FAB619/619-J_Stepper/files/Kicad Files/Stepper Servo.kicad_pcb

## KiCad design files/Kicad Files/Stepper Servo.kicad_pcb (2021-04-22)

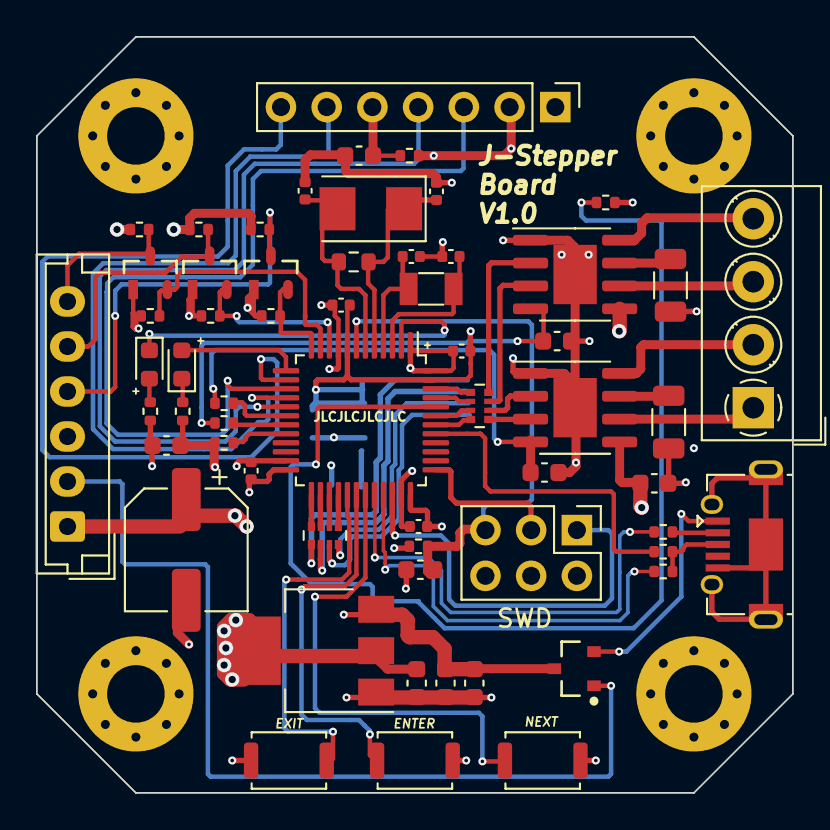
[picture p15: board Stepper Servo.kicad_pcb from above]

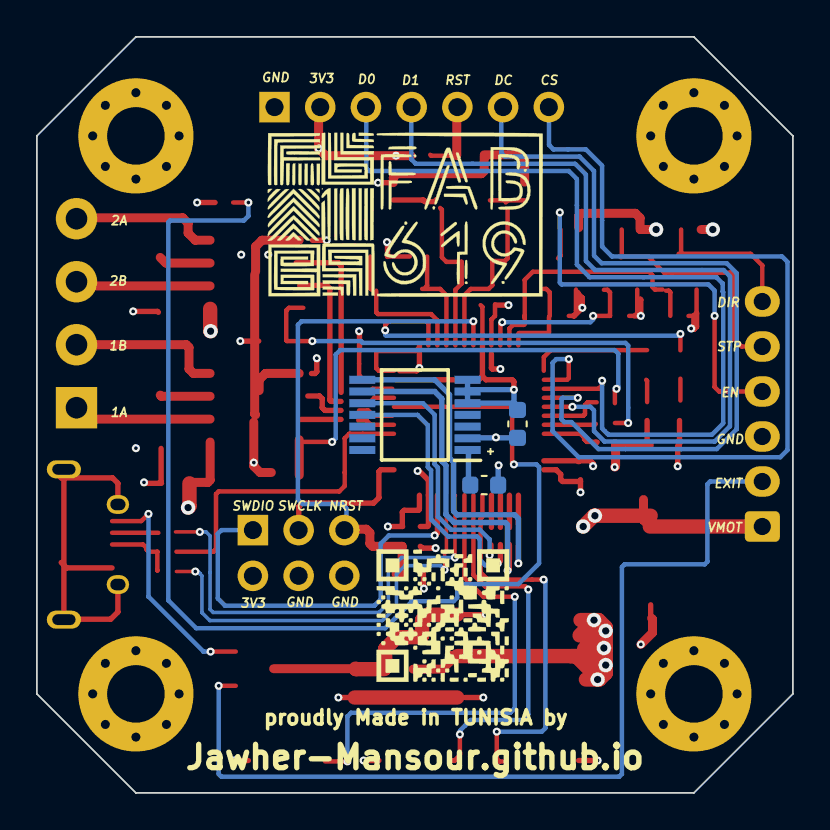
[picture p16: board Stepper Servo.kicad_pcb from below]

Board: 4 copper layers, 42.0 x 42.0 mm, 67 parts (3 on the bottom side), 65 nets.

Parts:
C1, C2, C3, C7, C14, C15, C16, C17, C18, C19, C20: 100nF; C_0603_1608Metric
C4, C5: 10pF; C_0402_1005Metric
C6: 100uF; CP_Elec_6.3x5.3
C8, C9: 22pF; C_0402_1005Metric
C10, C11, C12, C13: 100nF; C_0402_1005Metric
D1: LED; LED_0603_1608Metric
D2: LED_Small; LED_0603_1608Metric
D3: BAT64-05; Infineon-BAT64-05-Level_C
H1, H2, H3, H4: MountingHole_Pad; MountingHole_3.2mm_M3_Pad_Via
IC1: A1333LLETR-5-T; SOP65P640X125-14N
J1: USB_B_Micro; USB_Micro-AB_Molex_47590-0001
J2: SWD; PinHeader_2x03_P2.54mm_Vertical
J3: Motor; TerminalBlock_MetzConnect_Type059_RT06304HBWC_1x04_P3.50mm_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
J4: Screen; PinHeader_1x07_P2.54mm_Vertical
J5: Inputs; JST_EH_B6B-EH-A_1x06_P2.50mm_Vertical
Q1, Q2, Q3: FDN337N; ON_Semi-527AG-01-12_2008-O-IPC_C
R1, R3, R10, R12: 1K; R_0402_1005Metric
R2, R11: 0.1; R_1206_3216Metric
R4, R5, R8, R14, R15, R16, R17, R18, R19, R20: 10K; R_0402_1005Metric
R6, R9: 22; R_0402_1005Metric
R7: 1K5; R_0402_1005Metric
R13: 1M; R_0603_1608Metric
RN1: 10; R_Array_Convex_4x0402
RN2: 100; R_Array_Convex_4x0402
SW1, SW2, SW3: SW_DIP_x01; SW_Push_SPST_NO_Alps_SKRK
U1, U3: A4950E; SOIC-8-1EP_3.9x4.9mm_P1.27mm_EP2.41x3.3mm
U2: STM32F103C8T6; LQFP-48_7x7mm_P0.5mm
U4: AMS1117-3.3; SOT-223-3_TabPin2
Y1: 32K768; Crystal_SMD_3215-2Pin_3.2x1.5mm
Y2: 8MHz; Crystal_SMD_5032-2Pin_5.0x3.2mm

Connections:
1A: J3.1, U3.6
1B: J3.2, U3.8
2A: J3.4, U1.8
2B: J3.3, U1.6
+3V3: C10.2, C11.2, C12.2, C13.2, C19.2, C20.2, J2.2, J4.2, Q1.1, Q2.1, Q3.1, R8.1, R10.2, R14.1, R15.1, R17.1, R19.1, U2.1, U2.9, U2.24, U2.36, U2.48, U4.2
+5V: C14.2, C16.2, C18.2, D3.3, IC1.2, U4.3
A2: RN1.8, U2.25
A9450_IN1: RN2.8, U2.42
A9450_IN2: RN2.7, U2.43
A9450_IN3: RN2.6, U2.45
A9450_IN4: RN2.5, U2.46
BOOT0: R5.1, U2.44
BOOT1: R4.1, U2.20
DIR: J5.6, Q3.2, R20.2
DIR1: Q3.3, R19.2, U2.11
EN: J5.4, Q2.2, R18.2
EN1: Q2.3, R17.2, U2.12
ENTER: SW2.1, U2.30
EXIT: SW1.1, U2.29
GND: C1.1, C2.2, C3.1, C4.2, C5.2, C6.2, C7.1, C8.2, C9.2, C10.1, C11.1, C12.1, C13.1, C14.1, C15.1, C16.1, C17.2, C18.1, C19.1, C20.1, H1.1, H2.1, H3.1, H4.1, IC1.5, IC1.6, IC1.7, J1.5, J1.6, J2.4, J2.6, J4.1, J5.3, R2.1, R4.2, R5.2, R11.1, R12.1, SW1.2, SW2.2, SW3.2, U1.1, U1.9, U2.8, U2.23, U2.35, U2.47, U3.1, U3.9, U4.1
IN1: RN2.1, U3.3
IN2: RN2.2, U3.2
IN3: RN2.3, U1.3
IN4: RN2.4, U1.2
MISO: RN1.6, U2.27
MOSI: RN1.5, U2.28
NEXT: SW3.1, U2.31
NRST: C7.2, J2.5, R8.2, U2.7
unnamed: C1.2, R1.1, U1.4
unnamed: C3.2, R3.1, U3.4
unnamed: C15.2, J4.5, R14.2
unnamed: C17.1, IC1.1
unnamed: D1.2, R10.1
unnamed: D2.1, R12.2
unnamed: IC1.8, RN1.1
unnamed: IC1.9, RN1.2
unnamed: IC1.10, RN1.4
unnamed: IC1.11, RN1.3
unnamed: J1.2, R6.1
unnamed: J1.3, R7.2, R9.1
unnamed: R2.2, U1.7
unnamed: R11.2, U3.7
OLED_CS: J4.7, U2.14
OLED_D1: J4.4, U2.17
OLED_DC: J4.6, U2.16
OLED_DO: J4.3, U2.15
OSC32IN: C4.1, U2.3, Y1.1
OSC32OUT: C5.1, U2.4, Y1.2
SCK: RN1.7, U2.26
STP: J5.5, Q1.2, R16.2
STP1: Q1.3, R15.2, U2.10
SWCLK: J2.3, U2.37
SWDIO: J2.1, U2.34
USB_C: R7.1, U2.41
USB_D+: R9.2, U2.33
USB_D-: R6.2, U2.32
VBUS: D3.2, J1.1
VCC: D3.1, J5.2, R16.1, R18.1, R20.1
VMOT: C2.1, C6.1, J5.1, U1.5, U3.5
VREF12: R3.2, U2.18
VREF34: R1.2, U2.19
XTALin: C8.1, R13.1, U2.5, Y2.1
XTALout: C9.1, R13.2, U2.6, Y2.2
bLED: D1.1, U2.2
rLED: D2.2, U2.13
