FAB619/619-J_Stepper/(threads)

Thread 1 (2021-12-06):

Add support for Polulu Stepperdrivers

feroxib, 2021-12-06:
Hi,
i recently discorvered your repo and it really is what i was seeking for a long time. Except for one tiny bit... **The Stepper Driver**.
Im currently running on TMC2209 and dont want to miss them any second.
I noticed that you didnt contribute for quite some time but i will still ask this question.
Are you interested in adding in support for different stepper drivers?
My initial idea was to get **support for polulu** format stepper drivers so you can easily put in anything you might want.
How do you like the idea in general?
I analyzed the schematices of your project and think it **should be possible**.
If you want i can also help and commit to your repo if youd like that.

Thanks for your work and your reply.
feroxib
